otmaniamine/meteo-station/figures/anemometre design DIY.png

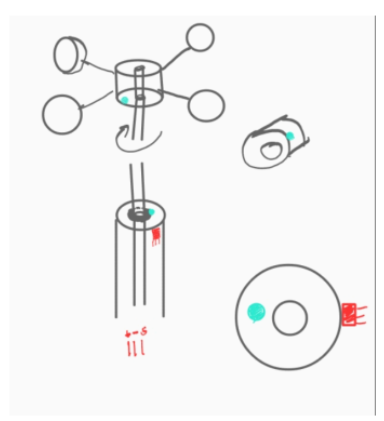
figures/anemometre design DIY.png
