otmaniamine/meteo-station/Station/shema.jpg

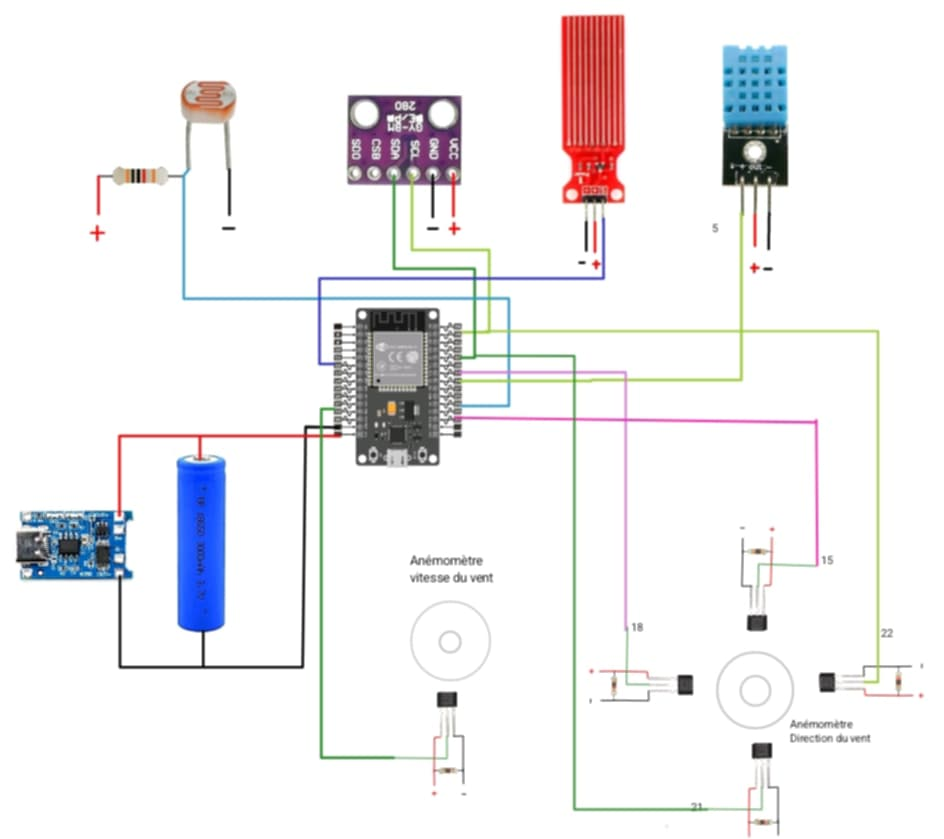
Station/shema.jpg
