otmaniamine/meteo-station/Interface/src/components/akram.jpeg

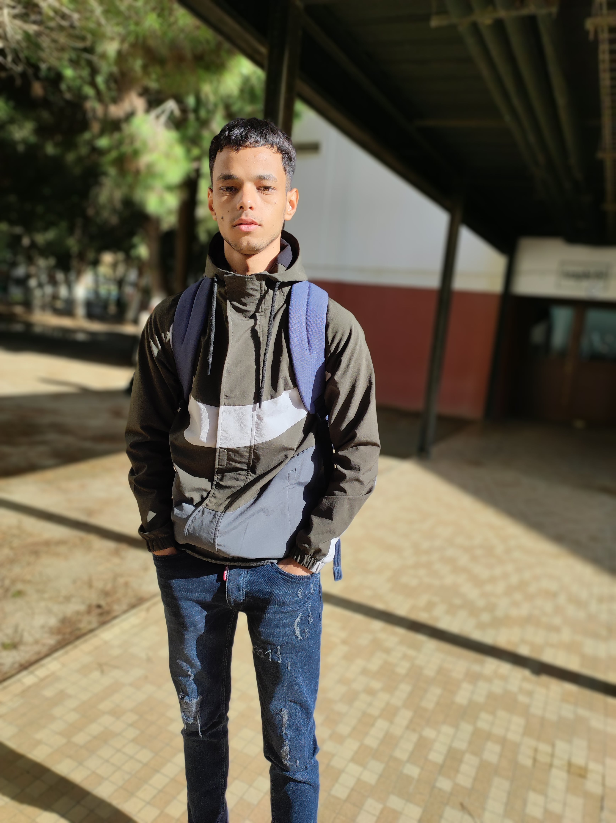
Interface/src/components/akram.jpeg
