otmaniamine/meteo-station/Interface/src/components/DSC_0383.jpg

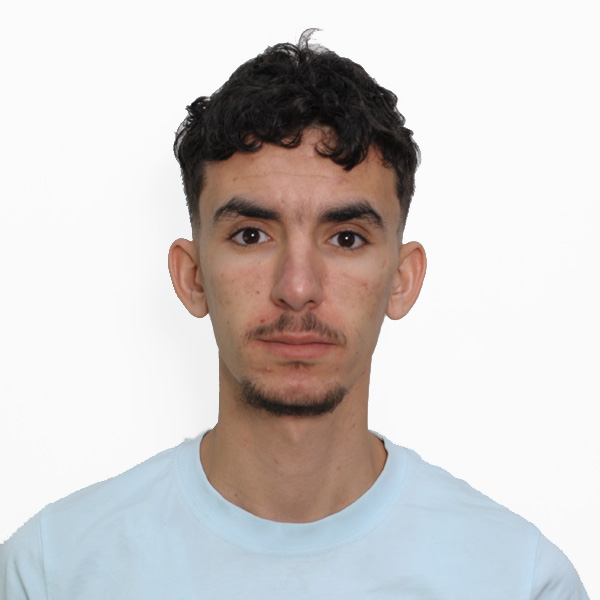
Interface/src/components/DSC_0383.jpg
