otmaniamine/meteo-station/Interface/src/components/DSF9246.jpg

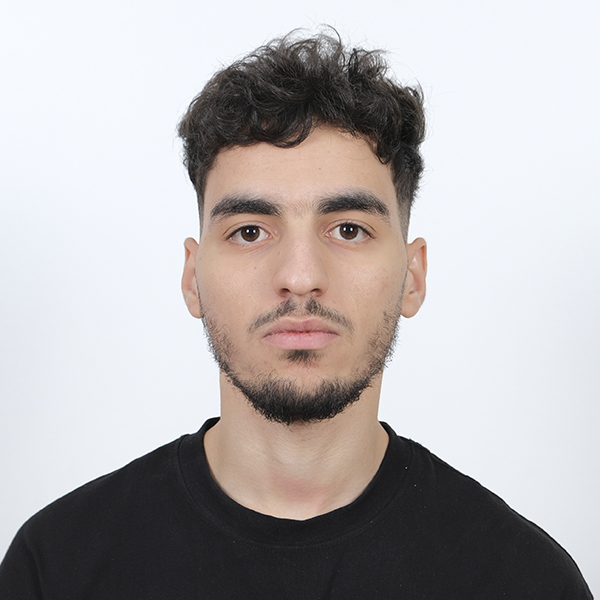
Interface/src/components/DSF9246.jpg
