otmaniamine/meteo-station/Interface/src/components/islam.jpg

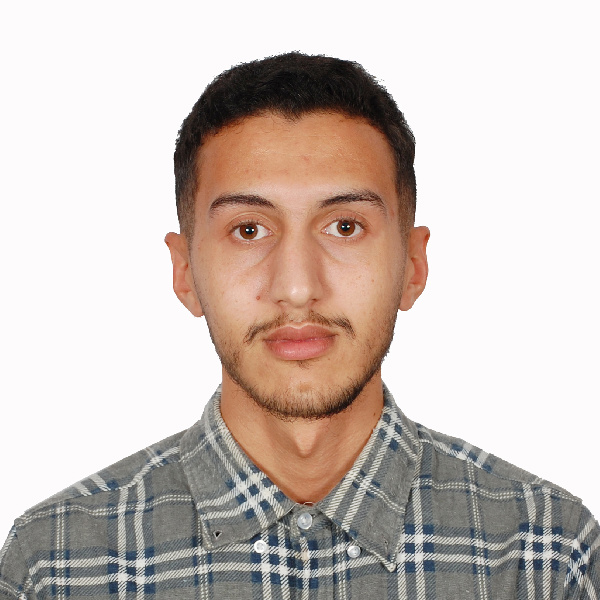
Interface/src/components/islam.jpg
