otmaniamine/meteo-station/(commit log)

2025-01-07 create 4 hall pins
2025-01-21 data base
    [DHT11_monitoring.xlsx]
